traulab/DIYNAFLUOR/DIYNAFLUOR BOM.xlsx

Filter Cube
Item | Price USD | Bulk Units | Units Req'd | Price (USD) | comment | Link
4 x M3 35 mm metal screw (Torx head) | 10.53 | 50 | 4 | 0.84 |  | Link (https://www.ebay.com.au/itm/256053890728?emsid=e11050.m43.l1123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)
4 x M3 nut | 8.58 | 100 | 4 | 0.34 |  | Link (https://www.ebay.com.au/itm/302773386063?var=601654779216)
2 x M2 8 mm metal screw (Torx head) | 8.47 | 50 | 2 | 0.34 |  | Link (https://www.ebay.com.au/itm/256033877138?var=555977967802)
2 x M2 nut | 7.26 | 50 | 2 | 0.29 |  | Link (https://www.ebay.com.au/itm/302773386063?var=601654779216)
1 x 470 nm LED (C503B-BAS-CZ0A0452) | 0.28 | 1 | 1 | 0.28 |  | Link (https://au.mouser.com/ProductDetail/Cree-LED/C503B-BAS-CZ0A0452?qs=UHyCXFkX5Ext5H/FTsWtqw%3D%3D)
1 x 470 nm Bandpass filter 10x10x1 mm | 7.27 | 1 | 1 | 7.27 | Tangsinuo Store may be the only supplier - Also used for Qubit Protein Assay | Link (https://www.aliexpress.com/item/1005005823090800.html)
1 x 525 nm bandpass filter 10x10x1 mm | 7.27 | 1 | 1 | 7.27 | Tangsinuo Store may be the only supplier | Link (https://www.aliexpress.com/item/1005005823090800.html)
1 x TSL2591 sensor board | 6.95 | 1 | 1 | 6.95 |  | Link (https://www.adafruit.com/product/1980)
1 x STEMMA QT / Qwiic JST SH 4-pin M Header Cable - 150mm Long (P4209B) | 0.95 | 1 | 1 | 0.95 |  | Link (https://www.adafruit.com/product/4209)
1 x M-F hookup cable (10 cm) | 6.88 | 80 | 1 | 0.09 |  | Link (https://www.ebay.com.au/itm/196101531443)
1 x F-F hookup cable (10 cm) | 6.88 | 80 | 1 | 0.09 |  | Link (https://www.ebay.com.au/itm/196101531443)
3d printed parts
3D Fillies Matte Black PLA Bulk Filament Cost | 19.77 | 1000 | g |  | 1000 g. Used to cost individual parts based on their mass from Simplify 3d | Link (https://3dfillies.com/pla-matte-1-75mm.html)
1 x Main Body (A) |  | 9.65 | g | 0.19
1 x Excitation Housing (B) |  | 3.59 | g | 0.07
1 x Emission Housing (C) |  | 4.63 | g | 0.09
1 x Emission Baffle (D) |  | 0.49 | g | 0.01
 |  |  | Total | 25.06
Body | Price USD | Bulk Units | Units Req'd | Price | comment | Link
Item
6 x M3 45 mm metal screw (Torx head) | 15.05 | 50 | 6 | 1.81 |  | Link (https://www.ebay.com.au/itm/256053890728?var=556000803650)
7 x M3 8 mm metal screw (Torx head) | 10.53 | 50 | 8 | 1.69 |  | Link (https://www.ebay.com.au/itm/256053890728?var=556000692597)
13 x M3 metal nut | 8.58 | 100 | 13 | 1.12 |  | Link (https://www.ebay.com.au/itm/302773386063?var=601654779216)
4 x M3 12 mm nylon screw (Phillips head) & 4 x M3 nylon nut | 2.94 | 50 | 4 | 0.24 | Can be purchased separately | Link (https://www.ebay.com.au/itm/355501332736?var=624652142666)
Arduino Uno R3 + USB A to USB B (M-M) cable | 19.47 | 3 | 1 | 6.49 |  | Link (https://www.ebay.com.au/itm/355342242901?var=624550731230)
1 x 68 Ohm 2W through-hole resistor PR02000206809JR500 | 0.23 | 10 | 1 | 0.02 |  | Link (https://au.mouser.com/ProductDetail/Vishay-BC-Components/PR02000206809JR500)
Double-sided tape (10 mm wide) |  |  |  |  | NA - Common item
3d printed parts
3D Fillies Matte Black PLA Bulk Filament Cost | 19.77 | 1000 | g |  | 1000 g. Used to cost individual parts based on their mass from Simplify 3d | Link (https://3dfillies.com/pla-matte-1-75mm.html)
1 x Base |  | 24.25 | g | 0.48
1 x Top Housing |  | 57.31 | g | 1.13
1 x Light Baffle Holder |  | 4.85 | g | 0.10
1 x Light Baffle |  | 4.11 | g | 0.08
4 x Foot |  | 1.48 | g | 0.03 | x4
 |  |  | Total | 13.17
 |  |  | Full Total | $38.24
Other items
1 x 630 nm Bandpass filter 10x10x1 mm | 7.27 | 1 | 1 | 7.27 | Tangsinuo Store may be the only supplier - Used for Qubit RNA BR Assay and Protein Assay | Link (https://www.aliexpress.com/item/1005005823090800.html)
1 x 682.5 nm Bandpass filter 10x10x1 mm | 7.27 | 1 | 1 | 7.27 | Tangsinuo Store may be the only supplier - Used for Qubit RNA BR | Link (https://www.aliexpress.com/item/1005005823090800.html)
1 x C503B-RAN-CA0C0AA2 | 0.19 | 1 | 1 | 0.19 |  | Link (https://www.digikey.com.au/en/products/detail/creeled-inc/C503B-RAN-CA0C0AA2/6561761)
3D printed Vanity Plate |  | 5.59 | g | 0.11 | Used 3D fillies Matte Black PLA bulk filament cost to calculate
3Drinted DIYNAFLUOR Logo for Baffle |  | 0.15 | g | 0.003 | Used 3D fillies Matte Black PLA bulk filament cost to calculate
3Drinted DIYNAFLUOR Logo for Baffle |  | 0.15 | g | 0.003 | Used 3D fillies Matte Black PLA bulk filament cost to calculate
3Drinted Light Baffle DIYNAFLUOR Logo Inset |  | 4.45 | g | 0.088 | Used 3D fillies Matte Black PLA bulk filament cost to calculate
 |  |  |  |  | AUD to USD 20240815
 |  |  |  |  | 0.66
