traulab/DIYNAFLUOR/experimental/Main Body (A) Experimental.stl

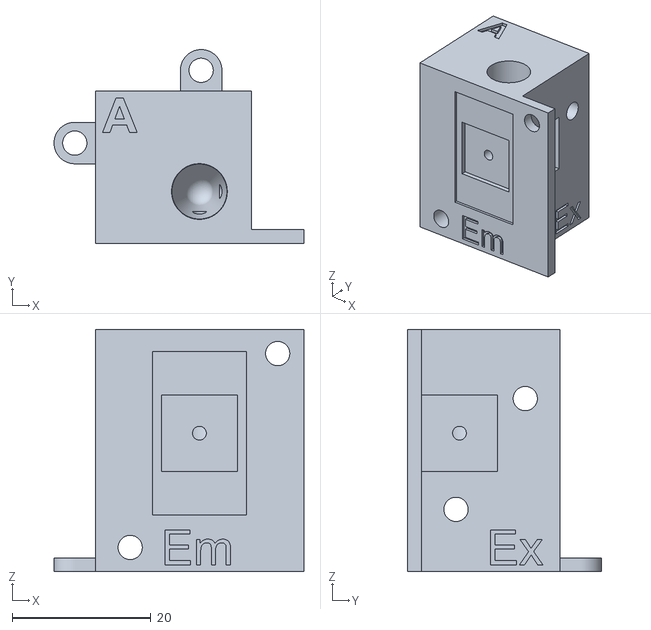
[picture p6: CAD file, 2025-03-01]
experimental/Main Body (A) Experimental.stl
36.1 x 28.0 x 35.0
