traulab/DIYNAFLUOR/experimental/Experimental sensitivity data.png

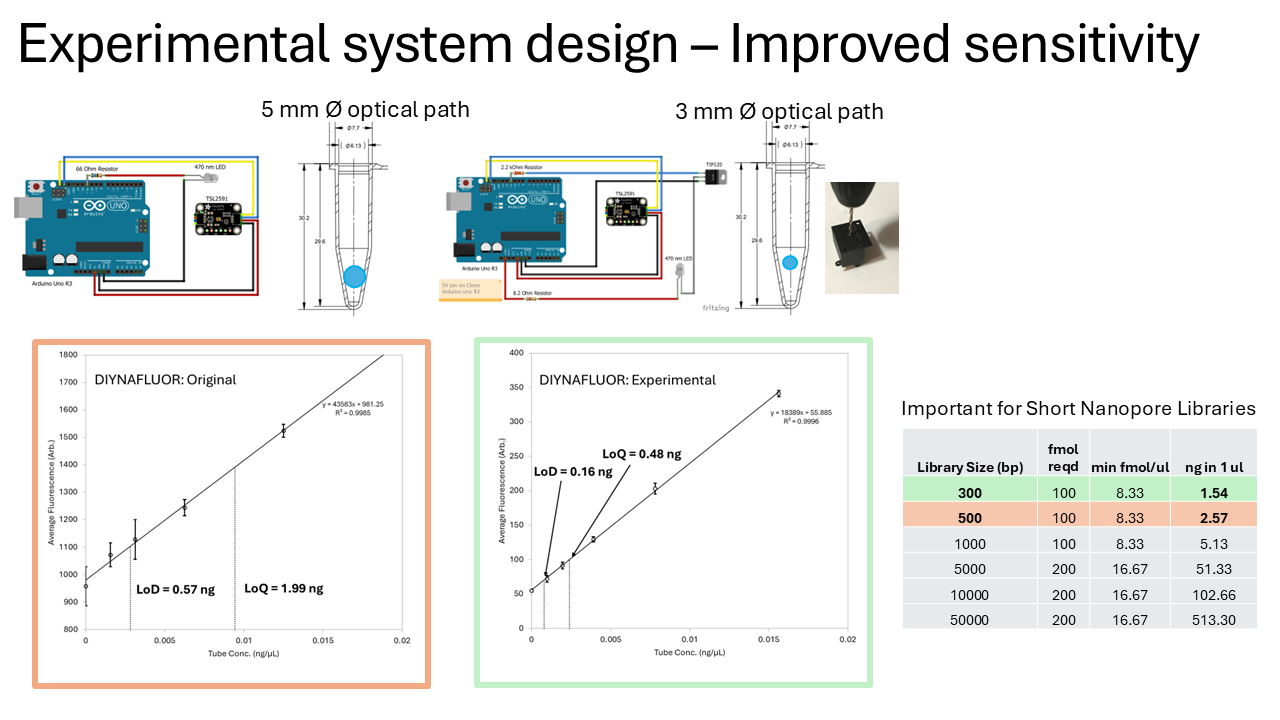
experimental/Experimental sensitivity data.png
