traulab/DIYNAFLUOR/(commit log)

2024-11-29 Change from 'Dilution Factor' to 'Sample Volume' Fixes #2
    [main.py]
2024-11-29 Rewrite float validation logic to handle invalid intermediate inputs better Fixes #1
    [main.py]
2024-11-29 Handle edge case where sample volume = 0
2024-11-29 Move CSV generation into model and remove unused fields from CSV generated by fluorometer model Fixes #4
    [main.py]
2024-11-29 Display warning box when performing an operation that may discard unsaved measurements. Fixes #5
    [main.py]
2024-11-29 Rewrite implementation of demo mode Fixes #3
    [fluorometer.py, main.py]
2024-11-29 Add validation/sanity-checking logic to standard measurements Fixes #7
    [main.py]
2024-11-29 Added dinosaur Fixes #6
    [main.py]
2024-11-29 Save readings for standards to CSV file Fixes #15
    [main.py]
2024-11-29 Add a version string to the GUI (should fix (#19)
    [main.py]
2024-11-29 Minor fix to button layout
    [main.py]
2024-12-01 3D Print Files
    Contains STL and STEP files in directories for the FIlter Cube, Body and Extras.
2024-12-01 Added DIYNAFLUOR BOM Excel File
    [DIYNAFLUOR_BOM.xlsx]
2024-12-01 Rename DIYNAFLUOR_BOM.xlsx to DIYNAFLUOR BOM.xlsx
    [DIYNAFLUOR BOM.xlsx]
2025-03-01 Rename A Main Body Experimental_20250112.stl to Main Body (A) Experimental
2025-03-01 Rename Main Body (A) Experimental to Main Body (A) Experimental.stl
    [Main Body (A) Experimental.stl]
2025-07-12 Update matplotlib dependency to fix Tcl_SetVar import error on current macOS
2025-07-12 Add workaround for macplotlib figure DPI issue, which resulted in extremely large plots on macOS
    [main.py]
2025-07-12 Bump secondary version (macOS support would be more than a bugfix, per semver conventions)
    [main.py]
2025-07-12 Fix DPI scaling on Windows
    [main.py]
2025-07-12 Fix taskbar icon on windows build
    [main.py]
2026-03-13 Add files via upload
    A short document to help eDNA Collab builders find the correct SCL and SDA sockets on their model or Arduino
2026-04-13 Update README.md
    updated readme to link to current release candidate of software...
2026-04-13 Update README.md
    Updated the first link for software release to current release page...
2026-06-28 USB B/C Base and Top Housing STL files
    Print these parts for the Base and Top Housing if you have a USB B or C Arduino clone.
